CloserPilot/CorrectorDeFactorDePotencia/README.md

# Corrector FP

*Funcionamiento del sensor de voltaje 
*Procedimiento para calibrar el sensor de corriente
