CloserPilot/CorrectorDeFactorDePotencia/Electronica simulada/Propuesta electronica.docx

Cálculos de corrientes, voltajes e impedancias.

Debido a limitaciones físicas con el uso de inductores, se decidió calcular teóricamente los valores de voltaje y desfase que deberian tener las señales de salida a 0°,20°,40° y 60°. Esto con el fin de modificar 2 señales senoidales.

Una señal de voltaje simularía el voltaje del circuito mientras que la otra señal de voltaje sería para los valores de corriente.

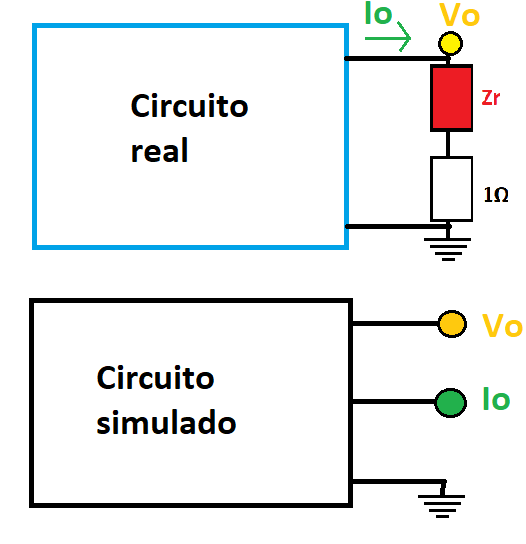
[picture p1: figure]
