CloserPilot/CorrectorDeFactorDePotencia/Otros/Sensor_voltaje/Sensor de voltaje.docx

Sensor de voltaje

La señal de salida máxima se encontrará dada por la siguiente ecuación:

Vo=Vo_(AC) +Vo_(DC) =10.5k((Vrms)/(830k))+2.5

*La salida de AC puede ser variada a niveles más bajos gracias al potenciómetro.
*Ésta ecuación se cumple siempre y cuando la relación (Vrms)/(830K)<1mA

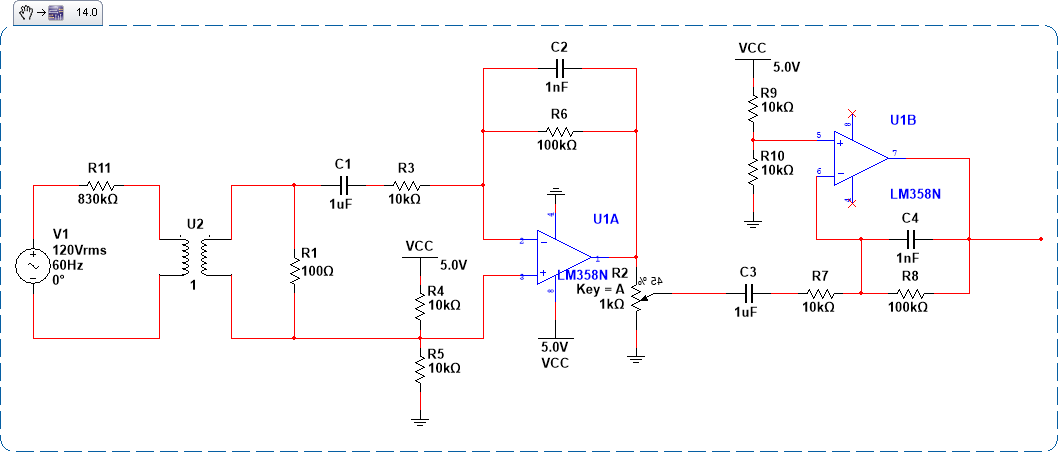
[picture p2: figure]
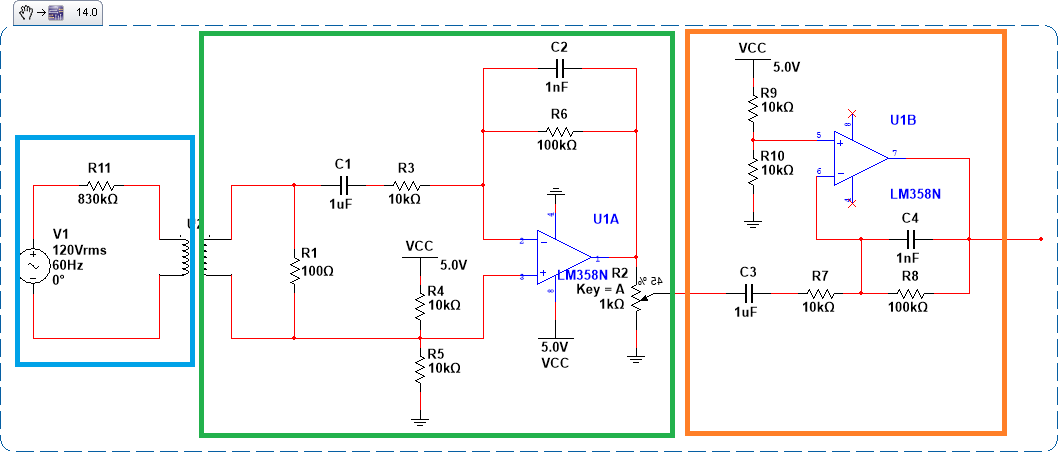
[picture p3: figure]

*El 0 de la señal de AC se encuentra a 2.5V. (Arduino).
*Contiene 2 filtros pasa bajas a frecuencia de corte ≈ 1500Hz.
*Contiene 2 filtros pasa altas a frecuencia de corte ≈ 16Hz.
*El transformador trabaja de 50-400Hz

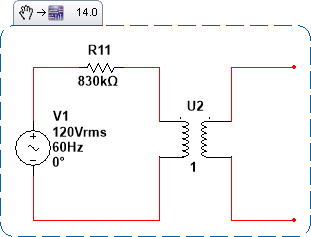
[picture p4: figure]

Funcionamiento del sensor (Parte Azul)

Por ley de ohm, la fuente de voltaje crea una corriente con la resistencia R11, la cual es reflejada gracias al transformador, al circuito de color verde, la relación del transformador es de 1:1, por lo cual es la misma corriente de ambos lados.

I_(trans) =(Vrms)/(830K)

Funcionamiento del sensor (Parte Verde DC)

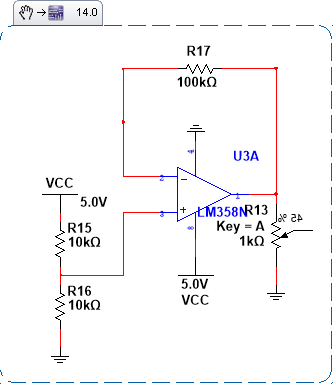
[picture p5: figure]
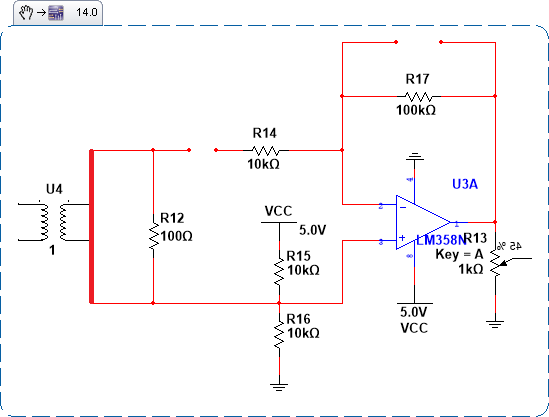
[picture p6: figure]

Apagando las fuentes de corriente alterna, poniendo los inductores como alambres y los capacitores como circuito abierto, se tiene:

Teniendo en la salida del opam el voltaje en la terminal no inversora, es decir 2.5V.

VoDC = 2.5V

Funcionamiento del sensor (Parte Verde AC)

Apagando las fuentes de en DC, viendo a los capacitores de 1uf como cortocircuitos y modelando el transformador como fuente de corriente en AC, el circuito es el siguiente:

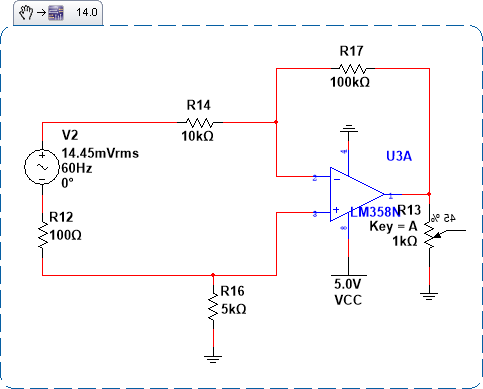
[picture p7: figure]

Nota: Los capacitores de 1nf serán vistos como circuitos abiertos ya que, por el bajo nivel del capacitor comparado con la resistencia, provoca que una corriente despreciable circule por él.

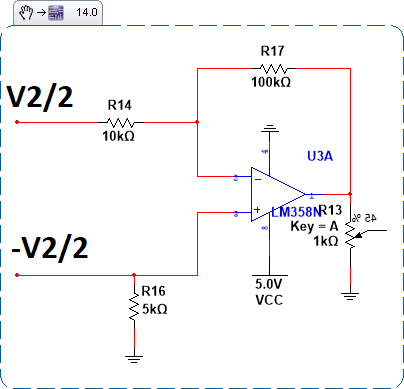
[picture p8: figure]
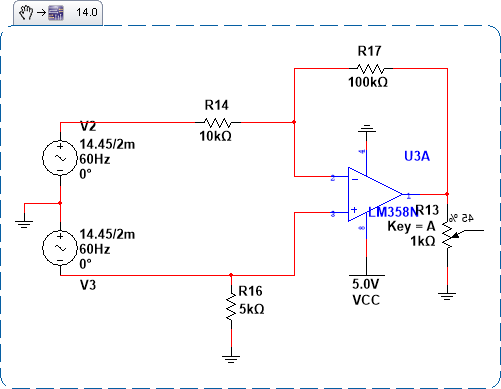
[picture p9: figure]
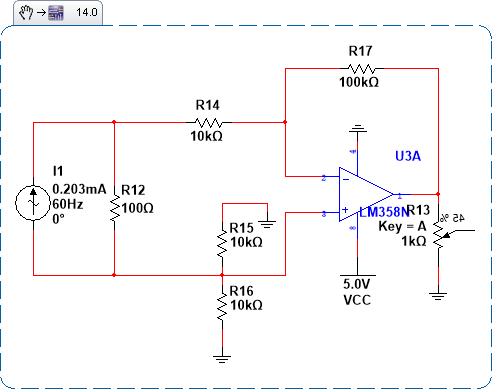
[picture p10: figure]

Despreciando la resistencia de 100Ω para simplificar el circuito:

La fuente de voltaje fue dividida en dos fuentes simétricas con un nodo a tierra para simplificar los cálculos, teniendo que la fuente V3 = -V2.

Para el voltaje (V_2)/2 , se tiene un amplificador inversor. La salida del opam tendrá de una ganancia -10.

Para el voltaje de (-V_2)/2 , se tiene un amplificador no inversor con salida de 11.

Finalmente, en el opam para AC, se tiene:

VoAC= (-10)(V_2)/2+(11)(-V_2)/2=-10.5V_2

VoAC= -10.5V_2

Vo_(AC) =-10.5*I_(trans) *100

Funcionamiento del sensor (Parte Verde DC y AC)

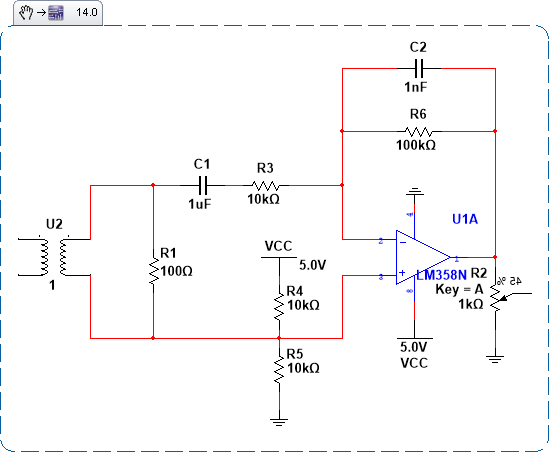
[picture p11: figure]

La señal alterna del transformador es puesta directamente sobre una señal de DC dada por el divisor de tensión de 5V, gracias a ésta señal es posible trabajar con AC teniendo únicamente alimentación positiva del opam.

Debido al capacitor C1, en DC se tendrá en al salida 2.5V como máximo, esto permite mantener el offset de todo el bloque.

En AC la señal de salida será amplificada -10.5 veces.

Vo=Vo_(AC) +Vo_(DC) =-10.5Vi+2.5 Vo=-10.5*I_(trans) *100+2.5

Se pasa de una señal diferencial a un voltaje nodal, además de tener un offset por la limitación de la fuente positiva.

Por último, el potenciómetro permite variar la intensidad de la señal de AC y DC vista en la siguiente parte del circuito.

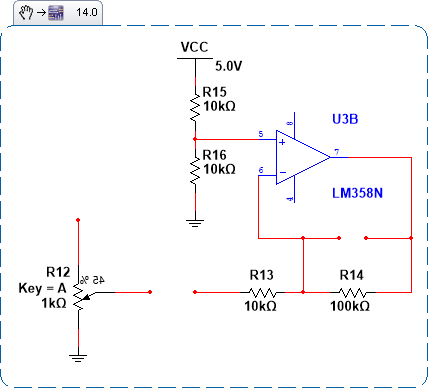
[picture p12: figure]

Funcionamiento del sensor (Parte Naranja DC)

Apagando las fuentes de AC y tomando los capacitores como circuitos abiertos, se tiene una configuración de seguidor de voltaje.

Vo_(DC) =2.5V

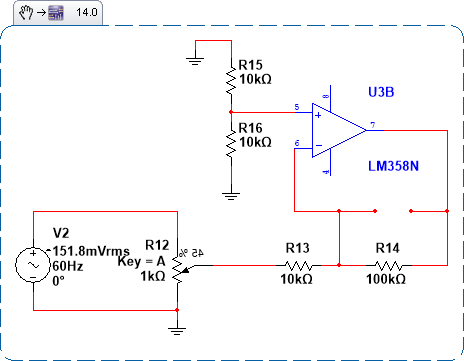
[picture p13: figure]

Funcionamiento del sensor (Parte Naranja AC)

Tomando el capacitor de 1uf como corto circuito, apagando las fuentes de DC y teniendo el capacitor de 1nf como circuito abierto, se tiene un amplificador inversor de ganancia máxima -10.

Vo_(AC) = -10Vi
Vo_(AC) =(-10)(-10.5*I_(trans) *100)

Funcionamiento del sensor (Parte Naranja DC y AC)

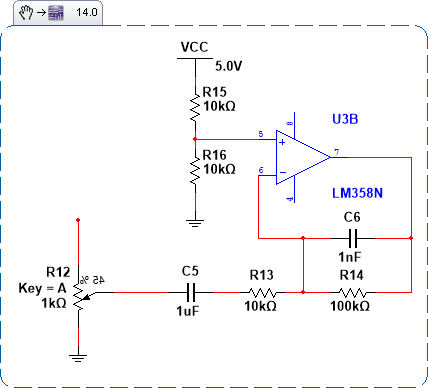
[picture p14: figure]

La señal de la etapa anterior con componentes de DC y AC es acoplada al nuevo circuito mediante el capacitor de 1uf, ésta nueva señal es inmediatamente puesta sobre otra señal de 2.5V para poder trabajar con ella (2.5V del circuito en DC siendo un seguidor de voltaje).

La señal en AC es amplificada por -10 unidades y entregada en la salida.

Vo=Vo_(AC) +Vo_(DC) =(-10)(-10.5*I_(trans) *100)+2.5

Vo_(AC) =10.5k*I_(trans) +2.5

Vo_(AC) =10.5k((Vrms)/(830k))+2.5
