CloserPilot/CorrectorDeFactorDePotencia/Otros/Sensor_voltaje/8.png

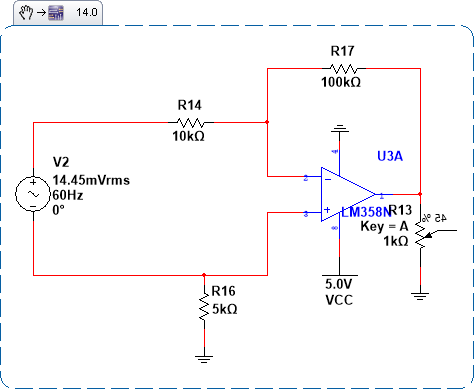
Otros/Sensor_voltaje/8.png
