CloserPilot/CorrectorDeFactorDePotencia/Sensor_voltaje.jpg

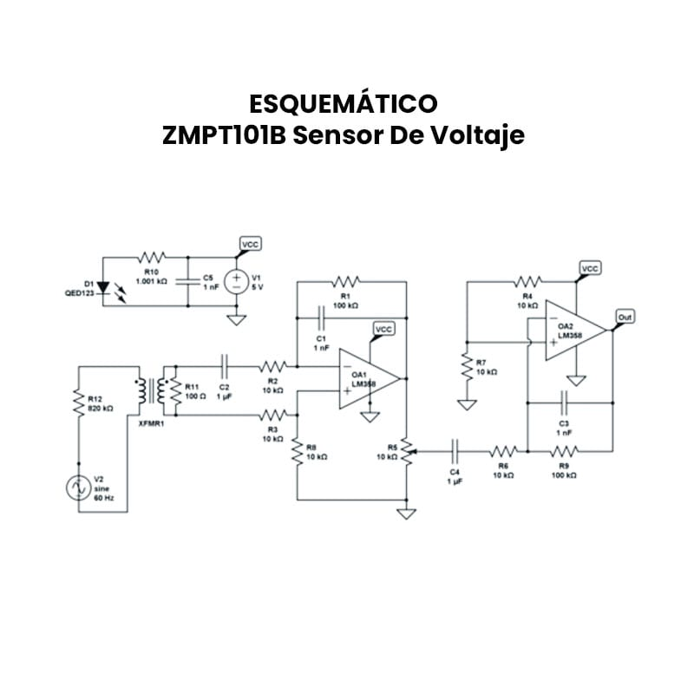
Sensor_voltaje.jpg
