CloserPilot/CorrectorDeFactorDePotencia/Costos.xlsx

 | Unidades necesarias | Unidades a pedir | Paquete | Costo por paquete | Envio | Total | Link
Inductores 10mH 4A. | 15 | 30 | 5 | 42.92 | 74.78 | 332.3 | https://es.aliexpress.com/item/1005002597114864.html?spm=a2g0s.9042311.0.0.40be63c0Hczh0B
Capacitores 10uf | 17 | 100 | 100 | 29.11 | 21.25 | 50.36 | https://es.aliexpress.com/item/32848919879.html?spm=a2g0s.9042311.0.0.40be63c0iqHlYR
Capacitores 1uf | 0 | 100 | 100 | 21.25 | 21.25 | 42.5 | https://es.aliexpress.com/item/32848919879.html?spm=a2g0s.9042311.0.0.40be63c0iqHlYR
Resistencia 24 Ω | 4 | 20 | 10 | 26.77 | 21.25 | 74.79 | https://es.aliexpress.com/item/32883621332.html?spm=a2g0s.9042311.0.0.40be63c0Hczh0B
Resistencia 33 Ω | 10 | 30 | 10 | 26.77 | 21.25 | 101.56 | https://es.aliexpress.com/item/32883621332.html?spm=a2g0s.9042311.0.0.40be63c0Hczh0B
Resistencia 1 Ω | 0 | 30 | 10 | 26.77 | 21.25 | 101.56 | https://es.aliexpress.com/item/32883621332.html?spm=a2g0s.9042311.0.0.40be63c0Hczh0B
 |  |  |  |  | Total | 703.07
