CloserPilot/CorrectorDeFactorDePotencia/(list of files, drawings)

Other design files:
Calibracion/Calibracion.ms14
Calibracion/Calibracion_AC712.fzz
Electronica simulada/Circuito real y simulado simple.ms14
Otros/Desfasador_180/Desafasador_180.ms14
Otros/Sensor_voltaje/Sensor_voltaje.ms14
Proyecto Electronico/Circuito Alta potencia.ms14
Proyecto Electronico/Circuito Arduino Compacto.ms14
Proyecto Electronico/Circuito Arduino.ms14
Proyecto Electronico/Diseno Completo.ms14
Proyecto Electronico/Diseno simple.ms14
Proyecto Electronico/Fuente de alimentacion.ms14
Sensor_voltaje.ms14
