CloserPilot/CorrectorDeFactorDePotencia/(commit log)

2021-11-18 Actualizacion 1
    *Funcionamiento del sensor de voltaje
    *Procedimiento de calibracion del sensor de corriente
2021-11-27 Calibracion y ajuste de escalas
    Se tienen las calibraciones de potenciometros y las graficas de arduino, falta calcular el FP.
2021-12-04 Corrector FP, muestras
    Menor cantidad de muestras en la pantalla, señal más clara
    [Corrector_de_factor.ino]
2021-12-04 Corrector FP 3
    Agrego de un retraso para ver mejor las señales, ESTO NO DEBERIA FUNCIONAR
    [Corrector_de_factor.ino]
2021-12-06 Consulta
    Links de consulta
2022-01-19 Diagramas de simulacion electronicos
    [Circuito Alta potencia.ms14, Circuito Arduino Compacto.ms14, Circuito Arduino.ms14, Diseno Completo.ms14, Diseno simple.ms14, Fuente de alimentacion.ms14]
2022-02-18 Actualizacion
    Todos los archivos a git
    [Calculos impedancias.xlsx, Calculos.xlsx, Calibracion.ms14, Calibracion_AC712.fzz, Circuito real y simulado simple.ms14, Costos.xlsx, Desafasador_180.ms14, Sensor_voltaje.ms14]
